yongava/-/README.md

# Honeycomb Pickleball Paddle

ไม้พิกเกิลบอลแบบชิ้นเดียว ไม่มีแผ่นผิวหน้า หน้าไม้เป็นรังผึ้งหกเหลี่ยมที่ทะลุตลอดความหนา
ยึดด้วยขอบตันรอบหน้าไม้ และต่อเป็นชิ้นเดียวกับด้ามจับทรงแปดเหลี่ยมยาว 6 นิ้ว
โดยหน้าไม้อยู่กึ่งกลางความหนาของด้าม มีสามทรง คือมาตรฐาน, hybrid และ elongated
โดยอิงขนาดจากไม้รุ่นปัจจุบันของ Selkirk, JOOLA และ RPM

โครงหน้าไม้ใช้หลัก "กรอบหนัก โครงในเบา" ผนังรังผึ้งด้านในบาง 0.8 mm
และขอบด้านข้างช่วง 3 กับ 9 นาฬิกาหนาขึ้นเป็นแผ่นตัน (side pad)
ซึ่งเป็นผลจากการเทียบรูปแบบโครงหน้าไม้ในหัวข้อ [งานวิจัยรูปแบบโครงหน้าไม้](#งานวิจัยรูปแบบโครงหน้าไม้)
(ฉบับมีแผนที่การเด้งของลูก: [Paddle Lattice Study](https://claude.ai/artifact/4r3fAmXzSW8QdgEV1mNDPP))

แบบล่าสุดคือทรง elongated แกนรังผึ้ง 14 mm หุ้มผิวตาข่ายถักด้านละ 0.8 mm เพื่อเพิ่มสปิน
(ดู [ผิวตาข่ายถักบนแกน 14 mm](#ผิวตาข่ายถักบนแกน-14-mm) และโมเดล 3 มิติที่มีปุ่มเปิดปิดผิว:
[Honeycomb Pickleball Paddle](https://claude.ai/artifact/HdFxA8h9m2yCLM3t2ezmrv))

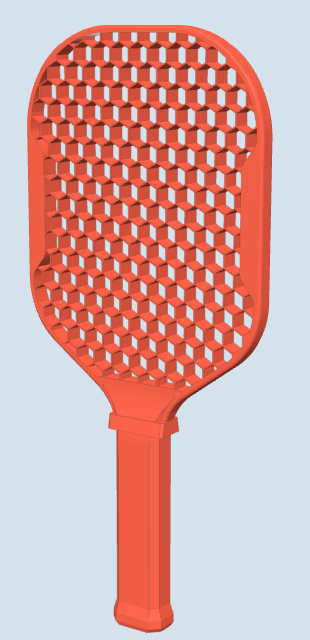
[picture p1: preview.png]
Elongated paddle preview


## ไฟล์

| ไฟล์ | รายละเอียด |
| --- | --- |
| `stl/pickleball_paddle_standard.stl` | ทรงมาตรฐาน |
| `stl/pickleball_paddle_hybrid.stl` | ทรง hybrid |
| `stl/pickleball_paddle_elongated.stl` | ทรง elongated |
| `stl/pickleball_paddle_<ทรง>_flat16.stl` | แบบพิมพ์นอน: หน้าไม้หนา 16 mm เท่าด้าม ช่องรังผึ้ง 18 mm (ดู [16 mm พิมพ์นอน](#16-mm-พิมพ์นอน)) |
| `stl/pickleball_paddle_elongated_diamond.stl` | ทางเลือก: ทรง elongated โครงลายข้าวหลามตัด ผนัง 1.0 mm |
| `stl/pickleball_paddle_elongated_mesh.stl` | แบบล่าสุด: ทรง elongated แกน 14 mm หุ้มผิวตาข่ายถักด้านละ 0.8 mm พิมพ์นอนชิ้นเดียว |
| `stl/pickleball_paddle_elongated_mesh_core.stl` | แกนเดียวกันแบบไม่มีผิว ผนังต่ำกว่าขอบด้านละ 0.8 mm |
| `generate_paddle.py` | สคริปต์สร้างโมเดล ปรับค่าได้จาก `HANDLE_LENGTH`, `SHAPES`, `LAY_FLAT`, `MESH_DESIGN` และค่าคงที่ที่ส่วนบนของไฟล์ |
| `analyze_paddle.py` | สคริปต์คำนวณน้ำหนัก swing weight, twist weight และแผนที่ sweet spot (รวมผิวตาข่ายถ้ามี) |
| `optimize_flat.py` | วนหาแบบพิมพ์นอนที่ดีที่สุดที่ความหนาที่กำหนด ทั้งแบบโครงเปิดและแบบมีผิวตาข่าย |
| `spin_model.py` | แบบจำลองสปินของลูกที่กระทบหน้าไม้แบบเฉียง เทียบผิวหน้าแบบต่าง ๆ |

## ทรง

ทุกทรงมีมุมบนมนรัศมีใหญ่ ด้านข้างตรง และส่วนล่างเรียวเป็นรูปตัว V ลงไปหาคอไม้
แล้วโค้งเว้าเข้าด้าม มีปลอกคอหุ้มรอยต่อระหว่างด้ามกับหน้าไม้ เหมือนไม้รุ่นปัจจุบัน
มุมบนและส่วนเรียวของทรง elongated ฟิตจากภาพ JOOLA Perseus (คลาดเคลื่อน RMS 0.9 mm)
แต่ด้านข้างตรงสั้นกว่า 15 mm เพราะด้ามยาวกว่า

| | มาตรฐาน | Hybrid | Elongated |
| --- | --- | --- | --- |
| ยาว × กว้าง | 400 × 197 mm (15.75 × 7.76 in) | 412.5 × 195.5 mm (16.24 × 7.70 in) | 419 × 190 mm (16.50 × 7.48 in) |
| ยาว + กว้าง (กติกาไม่เกิน 24 in) | 23.50 in | 23.94 in | 23.98 in |
| ความยาวด้าม (ถึงคอไม้) | 152.4 mm (6.00 in) | 152.4 mm (6.00 in) | 152.4 mm (6.00 in) |
| รัศมีมุมบน | 52 mm | 62 mm | 70 mm |
| ขอบด้านข้างหนาเพิ่ม (side pad) | 7 mm | 7 mm | 11 mm |
| ช่องรังผึ้ง | 219 | 223 | 209 |
| น้ำหนักโดยประมาณ | 223 g (7.9 oz) | 220 g (7.8 oz) | 224 g (7.9 oz) |
| จุดสมดุลจากปลายด้าม | 218 mm | 223 mm | 228 mm |
| Swing weight | 89 kg·cm² | 94 kg·cm² | 100 kg·cm² |
| Twist weight | 6.74 kg·cm² | 6.50 kg·cm² | 6.53 kg·cm² |
| ฐานพิมพ์จัตุรัสขั้นต่ำ (ตั้งสันข้าง วางทแยง) | 296 mm | 305 mm | 309 mm |
| ความสูงตอนพิมพ์ | 197 mm | 196 mm | 190 mm |

ทุกทรงใช้ค่าเดียวกันดังนี้: หน้าไม้หนา 13 mm, ขอบตัน 4.5 mm, ช่องรังผึ้งห่างกัน 15 mm ผนัง 0.8 mm,
ด้ามแปดเหลี่ยม 36 × 24 mm (เส้นรอบวง 108 mm หรือ 4.25 in) หน้าไม้อยู่กึ่งกลางด้าม
ด้ามจึงนูนออกจากหน้าไม้ด้านละ 5.5 mm

ความยาวรวมคงไว้ให้อยู่ในกติกา ด้ามที่ยาว 6 นิ้วจึงทำให้หน้าไม้สั้นกว่าไม้จริง 15–19 mm

น้ำหนักและค่าอื่นทั้งหมดคำนวณจากโมเดล โดยใช้ PETG ความหนาแน่น 1.25 g/cm³
ถือว่าหน้าไม้ตัน 100% และด้ามเติมเนื้อ 35%

## งานวิจัยรูปแบบโครงหน้าไม้

### วัดอะไรบ้าง

- **Swing weight:** โมเมนต์ความเฉื่อยรอบแกนที่ห่างจากปลายด้าม 5 cm หน่วย kg·cm² แบบเดียวกับเครื่อง Briffidi SW1 ที่ Pickleball Effect ใช้ ไม้ทั่วไปอยู่ที่ 70–130 เฉลี่ยราว 105
- **Twist weight:** โมเมนต์ความเฉื่อยรอบแกนกลางตามความยาวไม้ หน่วย kg·cm² ยิ่งสูงไม้ยิ่งบิดน้อยเมื่อตีไม่โดนกลาง
- **จุด center of percussion:** คิดจากจุดหมุนที่กลางฝ่ามือ 3 นิ้วจากปลายด้าม ตามวิธีของ Pickleball Science
- **Sweet spot:** จำลองลูกตกกระทบหน้าไม้ทุกจุดห่างกัน 5 mm แล้ววัดว่าลูกเด้งกลับเร็วแค่ไหน โดยแบบจำลองรวมทั้งการหมุนของทั้งไม้และการสั่นของโครงหน้าไม้ (แบบจำลองคานของผนังทุกเส้น ขอบ และด้าม) sweet spot คือพื้นที่ที่ลูกเด้งกลับอย่างน้อย 37% ของความเร็วขาเข้า (90% ของที่ไม้แข็งไม่บิดงอน้ำหนัก 213 g ทำได้ดีที่สุด) เวลาที่ลูกสัมผัสหน้าไม้ยังไม่มีใครวัดได้แน่ชัด จึงคำนวณทั้ง 1, 2 และ 4 ms

ค่าอ้างอิง: JOOLA Perseus Pro V 16mm หนัก 7.95 oz, swing weight 117, twist weight 6.26 ([Pickleball Effect](https://pickleballeffect.com/paddles/joola-perseus-pro-v-16mm/))

### เทียบรูปแบบที่น้ำหนักเท่ากัน

ทรง elongated ผนัง 1.0 mm ไม่มี side pad ทุกแบบใช้ความยาวผนังต่อพื้นที่เท่ากัน จึงหนักเท่ากัน

| รูปแบบ | น้ำหนัก | Swing weight | Twist weight | ความถี่โค้งงอ | ความถี่บิด | Sweet spot 1/2/4 ms | ช่วงผนังไร้ค้ำ |
| --- | --- | --- | --- | --- | --- | --- | --- |
| รังผึ้ง | 212.6 g | 93.5 | 4.95 | 52 Hz | 80 Hz | 2 / 14 / 34 cm² | 8.7 mm |
| สี่เหลี่ยม | 212.4 g | 93.3 | 5.00 | 75 Hz | 83 Hz | 7 / 10 / 20 cm² | 15 mm |
| ข้าวหลามตัด | 211.4 g | 92.6 | 4.85 | 52 Hz | 167 Hz | 0 / 8 / 23 cm² | 15 mm |
| สามเหลี่ยม | 213.9 g | 93.9 | 5.03 | 66 Hz | 132 Hz | 3 / 10 / 22 cm² | 26 mm |
| แปดเหลี่ยม (+ สี่เหลี่ยมเล็กในช่องว่าง) | 212.8 g | 93.1 | 4.99 | 55 Hz | 84 Hz | 1 / 8 / 27 cm² | 7.7 mm |

- ที่น้ำหนักเท่ากัน รูปแบบช่องแทบไม่เปลี่ยน swing weight และ twist weight (ต่างกันไม่เกิน 2%) เพราะสองค่านี้ขึ้นกับว่าเนื้อวัสดุอยู่ตรงไหน ไม่ใช่รูปร่างช่อง
- รูปแบบช่องเปลี่ยนความแข็งได้ สี่เหลี่ยมและสามเหลี่ยมแข็งต่อการโค้งงอกว่า ข้าวหลามตัดแข็งต่อการบิดกว่ารังผึ้งราว 2 เท่าในแง่ความถี่ แต่อันดับ sweet spot สลับไปมาตามเวลาสัมผัสลูก จึงสรุปไม่ได้ว่ารูปแบบไหนดีกว่าเพียงเพราะรูปร่างช่อง
- รังผึ้งมีช่วงผนังไร้ค้ำสั้นที่สุด เมื่อลูกกระแทกขอบผนัง ผนังยาวโก่งได้ง่ายกว่ามาก ประมาณการคร่าว ๆ คือที่น้ำหนักเท่ากัน รังผึ้งรับแรงก่อนผนังโก่งได้ราว 5 เท่าของข้าวหลามตัด จึงทำผนังให้บางได้มากที่สุด
- ทุกแบบยังอ่อนกว่าไม้คาร์บอนจริงมาก ไม้จริงที่ Pickleball Science วัดมีโหมดสั่นราว 1 kHz ส่วนโครงพิมพ์ไร้แผ่นผิวมีโหมดแรกแค่ 50–170 Hz

### สิ่งที่ได้ผลจริง: กรอบหนัก โครงในเบา

ย้ายเนื้อวัสดุจากโครงด้านในไปไว้ที่ขอบด้านข้าง (เหมือนติดเทปตะกั่วที่ 3 กับ 9 นาฬิกา
และเหมือนไม้เทนนิสที่กรอบหนักแต่เอ็นเบา) ทำให้ทั้ง twist weight และ sweet spot ดีขึ้นในทุกสมมติฐาน
ทั้งเวลาสัมผัส 1–4 ms, การหน่วงของวัสดุ 2–5%, ค่า E ของ PETG ที่พิมพ์ 1.6–2.0 GPa และค่าการเด้งของลูก 0.5–0.6

| ทรง elongated | น้ำหนัก | Swing weight | Twist weight | Sweet spot 1/2/4 ms | ลูกเด้งเฉลี่ยในวงรี 4.5 × 2.5 นิ้ว |
| --- | --- | --- | --- | --- | --- |
| เดิม: รังผึ้ง ผนัง 1.0 mm | 212.6 g | 93.5 | 4.95 | 2 / 14 / 34 cm² | 0.31 |
| ใหม่: รังผึ้ง ผนัง 0.8 mm + side pad 11 mm | 223.9 g | 99.7 | 6.53 | 34 / 39 / 58 cm² | 0.40 |
| ข้าวหลามตัด ผนัง 0.8 mm + side pad 11 mm | 223.2 g | 99.2 | 6.48 | 34 / 40 / 50 cm² | 0.40 |
| แปดเหลี่ยม ผนัง 0.8 mm + side pad 11 mm | 223.0 g | 99.0 | 6.51 | 20 / 33 / 50 cm² | 0.37 |
| ทางเลือก: ข้าวหลามตัด ผนัง 1.0 mm + side pad 6 mm | 226.3 g | 101.8 | 6.00 | 8 / 23 / 45 cm² | 0.35 |

ที่น้ำหนักเท่ากับแบบเดิมพอดี (ประมาณ 210 g ผนัง 0.72 mm + pad 8 mm) sweet spot ก็ยังโตจาก 2/14/34 เป็น 34/40/52 cm²
แปลว่าที่ดีขึ้นมาจากการย้ายตำแหน่งน้ำหนัก ไม่ใช่จากการเพิ่มน้ำหนัก

**สรุป:** เก็บช่องรังผึ้งไว้ แต่เปลี่ยนการกระจายน้ำหนักเป็นกรอบหนัก โครงในเบา ถ้าอยากได้ลายอื่น
ข้าวหลามตัดได้ sweet spot ใกล้เคียงกัน แข็งต่อการบิดกว่า และตอนพิมพ์ตั้งสันข้างไม่มีสะพานเลย
แต่ต้องใช้ผนังหนาขึ้นเป็น 1.0 mm เพื่อไม่ให้ผนังที่ยาวกว่าโก่งตอนตีแรง ไม้จึงหนักขึ้นและ sweet spot เล็กลง

แปดเหลี่ยมปูเต็มระนาบเองไม่ได้ ต้องมีสี่เหลี่ยมเล็กแทรกในช่องว่าง ได้ช่องใหญ่ราว 18 mm ปนช่องเล็ก
แข็งกว่ารังผึ้งเล็กน้อย (5–8% ในแง่ความถี่) แต่ sweet spot เล็กกว่าในทุกกรณี จึงไม่ดีกว่ารังผึ้ง

### จุดอ่อนของงานพิมพ์ 3D

งานพิมพ์ FDM แข็งแรงตามแนวเส้นพลาสติก แต่รอยต่อระหว่างชั้นมักรับแรงดึงได้เพียงราวครึ่งเดียวและแตกแบบเปราะ
เมื่อพิมพ์แบบตั้งสันข้าง ชั้นจะเรียงตามความกว้างของไม้ ผนังที่วิ่งตามความยาวไม้จึงแข็งแรง
แต่ผนังเฉียงของรังผึ้ง (2 ใน 3 ของผนังทั้งหมด) และขอบบนของหน้าไม้เป็นชั้นซ้อนกัน จึงเป็นจุดที่จะร้าวก่อน

ลองแนวทางใหม่สองแบบในแบบจำลองเดียวกัน (ทรง elongated)

| แบบ | น้ำหนัก | Swing weight | Twist weight | ความถี่โค้งงอ / บิด | Sweet spot 1/2/4 ms |
| --- | --- | --- | --- | --- | --- |
| ตอนนี้: หน้าไม้ 13 mm พิมพ์ตั้งสันข้าง | 223.9 g | 99.7 | 6.53 | 55 / 100 Hz | 34 / 39 / 58 cm² |
| แกนคาร์บอน: แท่งคาร์บอน 2 mm สองเส้นจากปลายด้ามถึงปลายหน้าไม้ | 233.6 g | 106.1 | 6.53 | 136 / 103 Hz | 18 / 12 / 23 cm² |
| หน้าไม้หนา 18 mm พิมพ์นอน (ด้าม 42 × 18 mm) | 222.9 g | 101.8 | 6.53 | 66 / 105 Hz | 25 / 42 / 42 cm² |
| หน้าไม้หนา 20 mm พิมพ์นอน (ด้าม 40 × 20 mm) | 225.5 g | 100.0 | 6.20 | 71 / 111 Hz | 20 / 47 / 28 cm² |

- แกนคาร์บอนทำให้ไม้แข็งขึ้น 2.5 เท่าและกันไม้หักได้ แต่ sweet spot เล็กลงมาก เพราะแกนแข็งกลางหน้าไม้ทำลายแรงดีดของโครงด้านในที่ทำงานเหมือนเอ็นไม้เทนนิส
- หน้าไม้หนาเท่าด้ามทำให้พิมพ์นอนได้โดยไม่ต้องใช้ซัพพอร์ตเลย และผนังทุกเส้นวิ่งตามแนวเส้นพลาสติก จึงแข็งแรงกว่ามาก
  แข็งขึ้น 20–30% และ sweet spot ใกล้เคียงเดิม แต่ด้ามแบนกว่าเดิม (เส้นรอบวงเท่าเดิม 108 mm) ช่องใหญ่ขึ้นเป็น 18–22 mm และต้องใช้ฐานพิมพ์ราว 350 mm

### 16 mm พิมพ์นอน

ภาพความเร็วสูงของ John Kew แสดงว่าลูกแนบหน้าไม้ไม่เกิน 2 ms
จึงให้น้ำหนักกับผลที่ 1–2 ms เป็นหลัก ทุกแบบถูกปรับขอบด้านข้างให้หนัก 225 g เท่ากัน

ถ้าแค่เปลี่ยนเป็น 16 mm โดยใช้โครงเดิม (ช่อง 15 mm ผนัง 0.8 mm) ไม้จะแข็งขึ้น 24% แต่ sweet spot เล็กลง
(19 / 36 / 53 cm² เทียบกับ 34 / 40 / 60 cm² ของแบบ 13 mm) เพราะโครงที่ลึกขึ้นแข็งขึ้นและเสียแรงดีดไป
จึงวนหาแบบที่ดีที่สุดที่ 16 mm (`optimize_flat.py`) โดยลอง 5 ลาย ช่อง 13–19 mm ผนัง 0.8–1.0 mm ขอบ 3–6.5 mm

- ลายข้าวหลามตัด สี่เหลี่ยม และสามเหลี่ยมตกเกณฑ์เกือบทั้งหมด เพราะผนังยาวจะโก่งเมื่อตีลูกแรง (เกณฑ์คือรับแรงได้อย่างน้อย 3 เท่าของลูกตบ 800 N)
- แปดเหลี่ยมผ่านเกณฑ์แต่ sweet spot เล็กกว่ารังผึ้ง
- ช่องใหญ่ขึ้น (โครงเบาลง) แล้วย้ายน้ำหนักไปที่ขอบ ยิ่งดี จนถึงช่อง 18 mm ช่อง 19 mm ผนังจะเริ่มโก่ง
- ลองเลียนแบบไม้ foam core ด้วยวงผนังบางรอบขอบ (เหมือน floating core / EVA รอบขอบ) ไม่ช่วยเลย (34/52/61 เทียบ 34/52/60 cm² ต่างกันไม่เกินความละเอียดของกริด) และทำให้ผนังรับแรงได้แค่ 1.8 เท่า
  ส่วนวงผนังหนาก็แย่ลง เพราะดึงน้ำหนักออกจากขอบด้านข้าง

ผลที่ดีที่สุด: รังผึ้ง ช่อง 18 mm ผนัง 0.8 mm ด้าม 42.7 × 16 mm (เส้นรอบวง 108 mm)

| ทรง (225 g) | ขอบ / side pad | Swing weight | Twist weight | ความถี่โค้งงอ / บิด | Sweet spot 1/2/4 ms | เทียบ 13 mm ตั้งสันข้าง |
| --- | --- | --- | --- | --- | --- | --- |
| มาตรฐาน | 4.5 / 5.4 mm | 97.5 | 7.50 | 77 / 99 Hz | 30 / 46 / 58 cm² | 28 / 36 / 54 cm² |
| Hybrid | 4.5 / 5.7 mm | 104.3 | 7.35 | 73 / 109 Hz | 31 / 46 / 60 cm² | 28 / 36 / 56 cm² |
| Elongated | 5.5 / 3.8 mm | 109.3 | 6.77 | 72 / 117 Hz | 34 / 52 / 60 cm² | 34 / 39 / 58 cm² |

แบบ 16 mm พิมพ์นอนดีกว่าแบบ 13 mm ในทุกทรง: sweet spot ที่ 2 ms ใหญ่ขึ้น 28–33% twist weight สูงขึ้น ไม้แข็งขึ้น
และผนังทุกเส้นพิมพ์ตามแนวเส้นพลาสติก ผลนี้ยังคงอยู่เมื่อลองการหน่วง 5%, E 1.6 GPa และลูกที่เด้งได้ 0.5 (ที่ 1–2 ms)
ข้อแลกคือ swing weight สูงขึ้นราว 10 ด้ามแบนกว่าเดิม ช่องกว้าง 17 mm ผนังรับแรงได้ 3.3 เท่า (แบบ 13 mm ได้ 5.6 เท่า)
และต้องใช้ฐานพิมพ์ราว 350–400 mm

### ผิวหน้าสำหรับสปินสูงสุด

ข้อมูลจาก John Kew: เมื่อทำให้ grit เท่ากันทุกไม้ ไม้แข็งกับไม้นุ่มต่างกันแค่ราว 250 rpm แต่เอา grit ออกเสียไปถึง 1,000 rpm
แบบจำลอง `spin_model.py` (ลูกกลวงกระทบหน้าไม้แบบเฉียง มีแรงเสียดทาน การยึดเกาะ และการดีดกลับด้านข้าง)
จำลองแท่นทดสอบของ John Kew คือลูก 70 mph ใส่ไม้ที่เอียง 30° โดยปรับให้ค่าแรงเสียดทาน 0.20 ได้ราว 2,000 rpm เท่าไม้ทั่วไป

| ผิว | แรงเสียดทาน | สปินที่ 70 mph | สปินที่ 40 mph | ลูกไถล |
| --- | --- | --- | --- | --- |
| ขอบผนัง PETG ที่พิมพ์ออกมา (ประมาณ) | 0.22 | 2,200 rpm | 1,260 rpm | 28 mm |
| Grit บนสันผนัง | 0.40 | 4,000 rpm | 2,290 rpm | 17 mm |
| ตาข่ายถักที่เชื่อมจุดไขว้ | 0.50 | 4,890 rpm | 2,790 rpm | 14 mm |
| ดอกยาง TPU บนสันผนัง | 0.90 | 7,590 rpm | 4,340 rpm | 13 mm |
| ครีบบางที่สปริงได้ | 0.45 | 3,470 rpm | 1,980 rpm | 6 mm |
| เส้นถักที่เลื่อนได้อิสระ | 0.45 | 2,080 rpm | 1,190 rpm | 8 mm |

- ในการทดสอบจริงลูกไถลตลอดการสัมผัส สปินจึงขึ้นกับแรงเสียดทานเกือบทั้งหมด
- เมื่อแรงเสียดทานเกินราว 0.35 ลูกจะยึดเกาะ แล้วความแข็งด้านข้างของผิวเริ่มสำคัญ ผิวจะดีดกลับทันในเวลาสัมผัสเมื่อแข็งด้านข้างราว 0.3–0.4 เท่าของด้านตั้งฉาก
- ผิวที่นุ่มด้านข้างมากเกินไป เช่นเส้นถักที่เลื่อนได้อิสระแบบเอ็นเทนนิส ได้สปินน้อยลง เพราะดีดกลับไม่ทันก่อนลูกออก
- ถ้าจะถักผิว ให้ถักแบบเชื่อมจุดไขว้ เน้นปุ่มนูนที่จุดไขว้ (0.3–0.5 mm) และใช้วัสดุที่ฝืด เช่น TPU
- ตัวเลขดอกยาง TPU เป็นเพดานจากแบบจำลองอย่างง่าย สปินสูงแลกกับความเร็วลูกที่ลดลง (ในแท่นทดสอบ 23.5 m/s เหลือ 12.4 m/s)
- วัดแรงเสียดทานของผิวที่พิมพ์ได้เอง: ติดลูกสามลูกเข้าด้วยกันเป็นสามเหลี่ยมเพื่อไม่ให้กลิ้ง วางบนแผ่นทดสอบแล้วค่อย ๆ เอียงจนเริ่มไถล
  ค่าแรงเสียดทานคือ tan ของมุมนั้น (เป้าหมาย 0.4 ขึ้นไป หรือราว 22°)

### ผิวตาข่ายถักบนแกน 14 mm

แกนรังผึ้งหนา 14 mm หุ้มด้วยตาข่ายที่เชื่อมทุกจุดไขว้ หนาด้านละ 0.8 mm รวม 15.6 mm (14 + 0.8 × 2)
หนาเท่าด้ามจึงยังวางนอนพิมพ์ได้โดยไม่ต้องใช้ซัพพอร์ต ผิวแบ่งเป็นส่วน นับจากแกนออกมา

| ส่วน | ระดับ | รายละเอียด |
| --- | --- | --- |
| เส้นทิศ A (+45°) | 0–0.6 mm | เส้นตรงกว้าง 0.8 mm พาดข้ามช่องจากผนังถึงผนัง บนหน้าบนพิมพ์ก่อนแบบสะพาน |
| ฝาผนัง | 0–0.4 mm | ปิดบนผนังทุกเส้น กว้างกว่าผนังข้างละ 0.1 mm ยึดผนังทุกเส้นกับผิว แม้ผนังที่เส้น A ตัดผ่านแบบเฉียงมาก |
| เส้นทิศ B (−45°) | 0.4–0.6 mm | เชื่อมกับเส้น A ทุกจุดไขว้ |
| ปุ่มนูน | 0.6–0.8 mm | กว้าง 1.0 mm ยาวเท่าระยะห่างตาข่าย อยู่ที่จุดไขว้ สลับทิศทีละจุดแบบผ้าทอ |

ผิวด้านหลังคือผิวเดียวกันที่พลิกกลับรอบแกนยาวของไม้ ทั้งสองหน้าจึงเหมือนกัน

- ผิว PETG ที่ยึดกับผนังทุกเส้นทำให้หน้าไม้กลายเป็นแผ่นแซนด์วิช ถ้าใช้โครงเดิม (ช่อง 18 mm ตาข่ายห่าง 4 mm)
  โหมดบิดขึ้นจาก 117 เป็น 160 Hz ผิวหนักราว 18 g ซึ่งต้องเอาออกจากขอบด้านข้าง และ sweet spot ที่ 2 ms ลดจาก 52 เหลือ 38 cm²
- ผิว TPU ที่นุ่มไม่เพิ่มความแข็ง แต่กลับแย่กว่าที่ 1–2 ms (29 cm²) และดีกว่าเฉพาะที่ 4 ms เพราะเมื่อลูกแนบสั้นหน้าไม้ต้องดีดกลับเร็ว
  ความแข็งของผิว PETG จึงช่วยได้ สิ่งที่เสียไปจริงคือน้ำหนักของผิว
- ผิวค้ำขอบบนของผนังไม่ให้โก่ง จึงขยายช่องได้ และตาข่ายที่ห่างขึ้นเบาลง เหลือน้ำหนักไปไว้ที่ขอบด้านข้างมากขึ้น

วนหาใหม่ 27 แบบต่อทรง (`optimize_flat.py --thickness 14 --skin 0.8`) ช่อง 18–20 mm ขอบ 3–5.5 mm ตาข่ายห่าง 4–6 mm
ทุกแบบหนัก 225 g เกณฑ์การโก่งคิดระยะค้ำตามระยะห่างตาข่าย และผนังต้องรับแรงกดจากลูกตบได้อย่างน้อย 1.5 เท่า

| ทรง (225 g) | ช่อง | ขอบ / side pad | ตาข่ายห่าง | Swing weight | Twist weight | Sweet spot 1/2/4 ms |
| --- | --- | --- | --- | --- | --- | --- |
| **Elongated (เลือก)** | 19 mm | 4.5 / 7.7 mm | 6 mm | 108.4 | 7.02 | 31 / 46 / 50 cm² |
| Hybrid | 20 mm | 4.5 / 5.4 mm | 5 mm | 105.2 | 7.22 | 26 / 45 / 49 cm² |
| มาตรฐาน | 20 mm | 4.5 / 4.9 mm | 5 mm | 99.5 | 7.35 | 24 / 42 / 45 cm² |

เลือกทรง elongated เพราะได้ sweet spot ใหญ่ที่สุดที่ 1–2 ms (เฉลี่ย 39 cm² เทียบกับ 36 และ 33 cm²) และนำมาทุกรอบของการวิเคราะห์
ข้อแลกคือ twist weight ต่ำสุดและ swing weight สูงสุดในสามทรง แต่ยังดีกว่าไม้ elongated รุ่นจริงที่ใช้อ้างอิง
(JOOLA Perseus Pro V 16mm: swing weight 117, twist weight 6.26; RPM Jade Elongated 16mm: 113 และ 5.94)

เทียบกับแบบ 16 mm ที่ไม่มีผิว ทรงเดียวกัน: sweet spot 31 / 46 / 50 เทียบกับ 34 / 52 / 60 cm² twist weight สูงขึ้น (7.02 เทียบกับ 6.77)
และผิวสองด้านหนัก 16 g สปินขึ้นกับแรงเสียดทานของผิว PETG ถักซึ่งยังไม่ได้วัด ที่ 0.3 ได้ราว 3,000 rpm และที่ 0.5 ได้ราว 4,890 rpm
(ขอบผนังเปล่า 2,200 rpm) ถ้าวัดได้ต่ำกว่า 0.4 ลองพิมพ์เฉพาะชั้นปุ่มนูนด้วย TPU แบบสองวัสดุ ปุ่มไม่รับแรงในโครงจึงไม่เปลี่ยน sweet spot
แต่แบบจำลองให้สปินราว 6,000 rpm

### ข้อจำกัดของแบบจำลอง

- เป็นแบบจำลองคาน (grillage) ของผนัง ขอบ และด้าม ไม่ใช่ FEA สามมิติเต็มรูปแบบ และยังไม่ได้ทดสอบกับชิ้นงานจริง
- ตัวเลข sweet spot ใช้เทียบระหว่างแบบ ค่าสัมบูรณ์ขึ้นกับเวลาสัมผัสลูก (ภาพของ John Kew บอกว่าไม่เกิน 2 ms)
- แบบจำลองสปินใช้จุดสัมผัสเดียวและสปริงเชิงเส้น ค่าแรงเสียดทานของผิวแต่ละแบบเป็นค่าประมาณ ควรวัดจริง
- การประเมินการโก่งของผนังเป็นการคำนวณคร่าว ๆ จากทฤษฎีคานลึก ควรทดสอบชิ้นงานจริงก่อนตีแรง ๆ
- ผิวตาข่ายคิดเหมือนแผ่นที่ยึดกับผนังแน่นตลอด ถ้ารอยต่อระหว่างผิวกับผนังยืดหรือเลื่อน ผิวจะช่วยให้แข็งน้อยกว่าที่คำนวณ

แหล่งข้อมูล: [Pickleball Science: swing weight](https://pickleballscience.org/what-do-the-swing-weight-numbers-mean/),
[Pickleball Science: sweet spot](https://pickleballscience.org/where-is-the-sweet-spot/),
[Pickleball Science: sweet spot size](https://pickleballscience.org/how-large-is-the-sweet-spot/),
[Pickleball Effect: วิธีทดสอบ](https://pickleballeffect.com/?p=39472),
[Pickleball Central: swingweight และ twistweight](https://pickleballcentral.com/blog/the-lab-at-pickleball-central-why-swingweight-twistweight-and-balance-points-matter-in-pickleball/),
[Pickleball Central: การติดเทปถ่วงน้ำหนัก](https://pickleballcentral.com/blog/lab-breakdown-ultimate-guide-to-using-weighted-tape/),
[The Dink: ภาพความเร็วสูงเรื่อง dwell time](https://www.thedinkpickleball.com/is-dwell-time-a-pickleball-myth-what-high-speed-footage-actually-reveals/),
[John Kew: Boomstik Infinigrit update](https://johnkewpickleball.beehiiv.com/p/johnkew-newsletter-boomstik-infinigrit-update),
[Pickleball.com: John Kew spin testing](https://pickleball.com/gear/john-kew-taking-spin-testing-to-the-next-level),
[Pickleball Science: friction and spin](https://pickleballscience.org/does-friction-create-more-spin/),
[Pickleball Effect: RPM Jade Elongated 16mm](https://pickleballeffect.com/paddles/rpm-jade-elongated-16mm/),
[Pickleball Effect: foam vs polymer cores](https://pickleballeffect.com/resources/foam-vs-polymer-core-breakdown/)

## ไม้รุ่นจริงที่ใช้อ้างอิง

| รุ่น | ทรง | ยาว (in) | กว้าง (in) | ด้าม (in) |
| --- | --- | --- | --- | --- |
| JOOLA Perseus | Elongated, หัวเหลี่ยม | 16.5 | 7.5 | 5.5 |
| JOOLA Hyperion | Elongated, หัวมน | 16.5 | 7.5 | 5.5 |
| RPM Friction Pro Elongated | Elongated | 16.5 | 7.5 | 5.5 |
| Selkirk Elongated | Elongated | 16.5 | 7.45 | 5.8 |
| Selkirk Invikta | Elongated | 16.5 | 7.375 | 5.25 |
| RPM Q2 Hybrid Flat Top | Hybrid | 16.25 | 7.7 | 5.5 |
| Selkirk Epic | มาตรฐาน | 15.75 | 8 | 5.25 |

ที่มา: [Selkirk shapes](https://www.selkirk.com/pages/shapes),
[Pickleheads: Perseus vs Hyperion](https://www.pickleheads.com/pickleball-gear/joola-perseus-vs-hyperion),
[Pickleball Central: RPM Friction Pro Elongated](https://pickleballcentral.com/rpm-friction-pro-14mm-elongated-v2-pickleball-paddle/),
[Matt's Pickleball: RPM Q2 Hybrid Flat Top](https://www.mattspickleball.com/paddle/q2-hybrid-flat-top-16mm)

## การพิมพ์

ด้ามนูนออกจากหน้าไม้ทั้งสองด้าน ถ้าวางนอน หน้าไม้จะลอยจากฐาน 5.5 mm ทั้งแผ่น จึงควรพิมพ์แบบตั้งสันข้าง

- ตั้งไม้บนสันข้างยาว ให้หน้าไม้ตั้งฉากกับฐาน (ในสไลเซอร์ หมุน 90° รอบแกนความยาวของไม้) side pad ทำให้สันที่แตะฐานกว้างขึ้นด้วย
- ช่องรังผึ้งจะกลายเป็นอุโมงค์แนวนอน เพดานแต่ละช่องเป็นสะพานยาวประมาณ 8 mm พิมพ์ได้โดยไม่ต้องมีซัพพอร์ตข้างใน
- ใช้ซัพพอร์ตแบบ tree ตั้งค่าให้แตะฐานเท่านั้น จะเกิดซัพพอร์ตใต้ด้ามและปลอกคอ (สูงจากฐาน 6–8 cm) และใต้โค้งปลายสองข้างของขอบล่าง (สูงไม่เกิน 2 cm)
- ใส่ brim 5–8 mm กันล้ม
- ฐานจัตุรัสตั้งแต่ 310 mm ขึ้นไปพอเมื่อวางทแยง และต้องพิมพ์ได้สูงประมาณ 200 mm ฐาน 350×350 ใส่ได้ทุกทรงพร้อม brim
- แนะนำ PETG เพราะทนแรงกระแทกดีกว่า PLA ผนัง 0.8 mm คือเส้นผนัง 2 เส้นจากหัวฉีด 0.4 mm ตั้งความกว้างเส้นราว 0.42 mm, เลเยอร์ 0.2 mm, ด้ามใช้ infill แบบ gyroid ประมาณ 15–20%

**แบบ 16 mm พิมพ์นอน (`_flat16`)** ทุกส่วนหนาไม่เกิน 16 mm ด้านล่างจึงเป็นระนาบเดียว

- วางนอนบนฐานได้เลย ไม่ต้องใช้ซัพพอร์ต ผนังทุกเส้นพิมพ์ตามแนวเส้นพลาสติก
- ต้องใช้ฐานจัตุรัสราว 350 mm เมื่อวางทแยง (ทรง hybrid 351 mm) แนะนำฐาน 400 mm ขึ้นไปเพื่อเผื่อ brim
- หัวฉีด 0.6 mm ทำผนัง 0.8 mm เป็นเส้นเดียวได้ ไม่มีรอยเชื่อมกลางผนัง

**แบบผิวตาข่าย (`_mesh`)** หนา 15.6 mm ทั้งหน้าไม้และด้าม

- วางนอนบนฐานได้เลย ไม่ต้องใช้ซัพพอร์ต ฐานจัตุรัสราว 350 mm เมื่อวางทแยง
- ใช้เลเยอร์ 0.2 mm ผิวแต่ละด้านจึงเป็น 4 เลเยอร์ ถ้าใช้ความสูงเลเยอร์แบบปรับได้ ให้ช่วงผิวสองด้านเป็น 0.2 mm พอดี
- ชั้นแรกบนฐานคือปุ่มนูนของผิวด้านล่าง เป็นชิ้นเล็กราว 1,100 ชิ้น ใช้ฐาน PEI ที่สะอาดหรือทากาว และพิมพ์ชั้นแรกช้า ๆ
- ชั้นแรกของผิวด้านบนพาดข้ามช่องยาวได้ถึงราว 21 mm เปิดการตรวจจับสะพาน (bridge) และพัดลมเต็มที่
- ไฟล์มีราว 160,000 สามเหลี่ยม (8 MB) เพราะปุ่มนูนทุกปุ่มเป็นรูปทรงจริง

ถ้าอยากวางนอนพิมพ์โดยไม่ใช้ซัพพอร์ตแต่ยังใช้หน้าไม้ 13 mm ใช้ `--grip flat` ได้ ด้ามจะเรียบเสมอกับด้านล่างของหน้าไม้
แต่หน้าไม้จะเยื้องจากแกนด้าม 5.5 mm

## สร้างใหม่และวิเคราะห์

```sh
pip install manifold3d numpy shapely scipy
python3 generate_paddle.py --all                       # ทุกทรง แบบแนะนำ
python3 generate_paddle.py --shape hybrid --grip flat
python3 generate_paddle.py --shape elongated --pattern diamond --wall 1.0 --side-pad 6
python3 analyze_paddle.py --shape elongated            # เทียบทุกรูปแบบ
python3 analyze_paddle.py --pattern honeycomb --wall 1.0 --side-pad 0
python3 generate_paddle.py --all --lay-flat            # แบบ 16 mm พิมพ์นอน
python3 optimize_flat.py --thickness 16 --shape elongated
python3 spin_model.py
python3 generate_paddle.py --mesh                      # แบบผิวตาข่าย ทรง elongated
python3 generate_paddle.py --mesh --no-skin            # แกนเดียวกันแบบไม่มีผิว
python3 optimize_flat.py --thickness 14 --skin 0.8 --shape elongated
```

รูปแบบที่มีให้เลือก: `honeycomb`, `square`, `diamond`, `triangle`, `octagon`

## ข้อควรรู้

- กติกา USA Pickleball ไม่อนุญาตให้หน้าไม้มีรู ไม้นี้จึงใช้แข่งในรายการที่รับรองไม่ได้ เหมาะกับการเล่นสนุกหรือซ้อม
- ทรง hybrid และ elongated ยาวรวมกว้างเกือบชนเพดาน 24 in เหมือนไม้จริง ถ้าพิมพ์แล้วชิ้นงานขยายตัวอาจเกินเล็กน้อย
- ผนัง 0.8 mm บางกว่าเดิม ควรลองตีเบา ๆ ก่อน และตรวจรอยร้าวที่ผนังหลังเล่น
- ผิวตาข่ายที่มีปุ่มนูนก็ผิดกติกาเรื่องผิวหน้าไม้เช่นกัน แบบนี้เป็นงานวิจัย
- `--mesh` ทรงมาตรฐานและ hybrid ได้ไฟล์ที่มีขอบเสียไม่กี่จุด สไลเซอร์ซ่อมให้อัตโนมัติ ส่วนทรง elongated สะอาดทั้งหมด
