yongava/-/stl/pickleball_paddle_elongated_mesh_core.stl

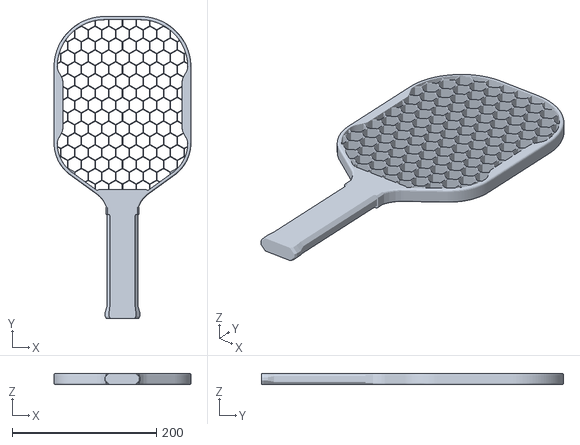
[picture p2: CAD file, 2026-11-11]
stl/pickleball_paddle_elongated_mesh_core.stl
190.0 x 419.0 x 15.6
