yongava/-/stl/pickleball_paddle_elongated_mesh.stl

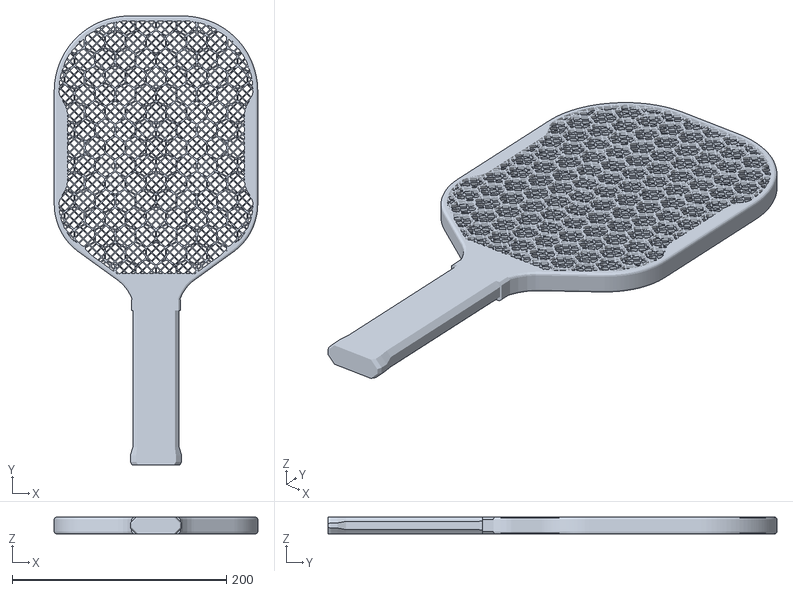
[picture p3: CAD file, 2026-11-11]
stl/pickleball_paddle_elongated_mesh.stl
190.0 x 419.0 x 15.6
