yongava/-/stl/pickleball_paddle_hybrid_flat16.stl

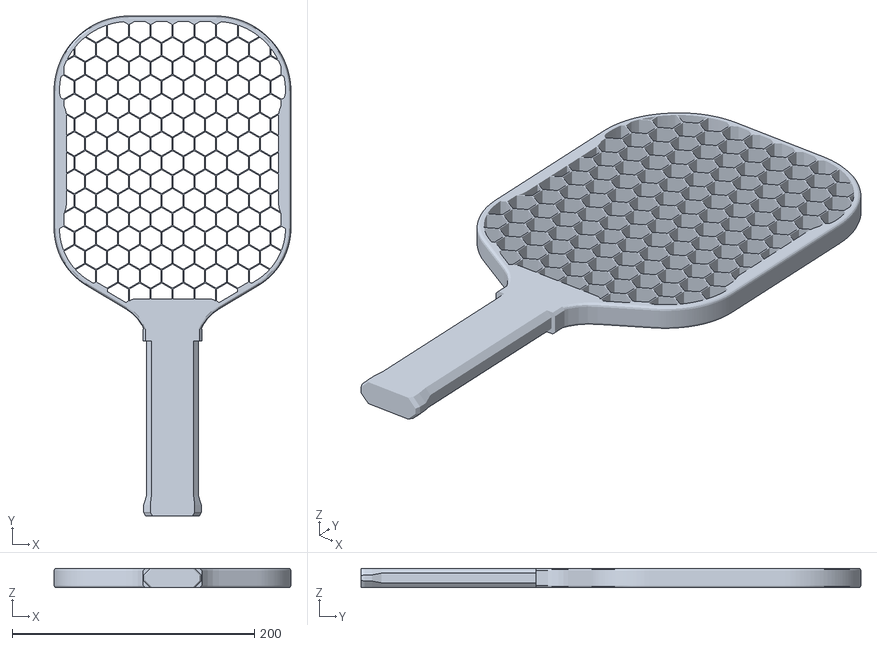
[picture p4: CAD file, 2026-11-06]
stl/pickleball_paddle_hybrid_flat16.stl
195.5 x 412.5 x 16.0
