yongava/-/stl/pickleball_paddle_standard_flat16.stl

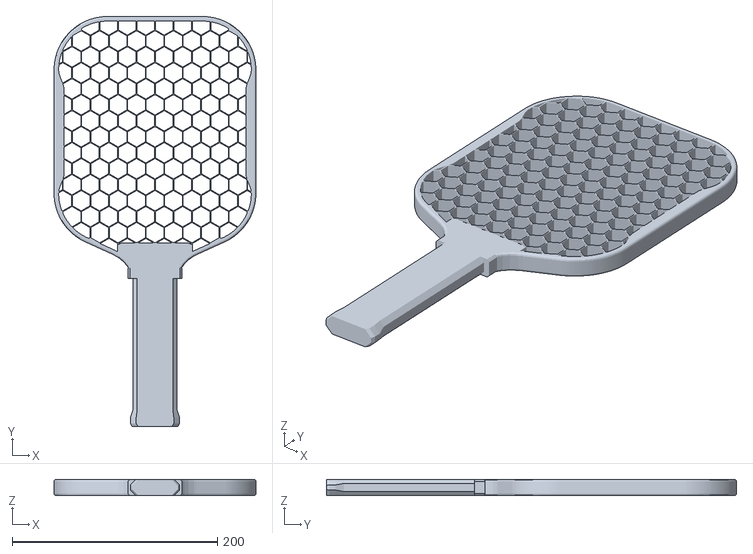
[picture p5: CAD file, 2026-11-06]
stl/pickleball_paddle_standard_flat16.stl
197.0 x 400.0 x 16.0
