yongava/-/stl/pickleball_paddle_elongated_flat16.stl

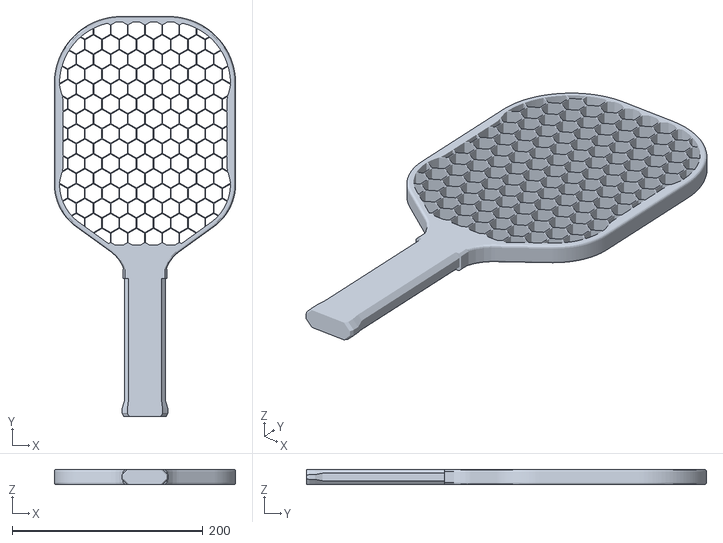
[picture p6: CAD file, 2026-11-06]
stl/pickleball_paddle_elongated_flat16.stl
190.0 x 419.0 x 16.0
