yongava/-/stl/pickleball_paddle_hybrid.stl

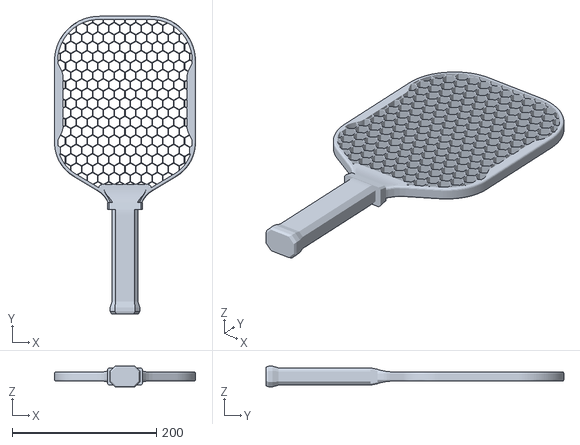
[picture p7: CAD file, 2026-11-06]
stl/pickleball_paddle_hybrid.stl
195.5 x 412.5 x 28.5
