yongava/-/stl/pickleball_paddle_elongated.stl

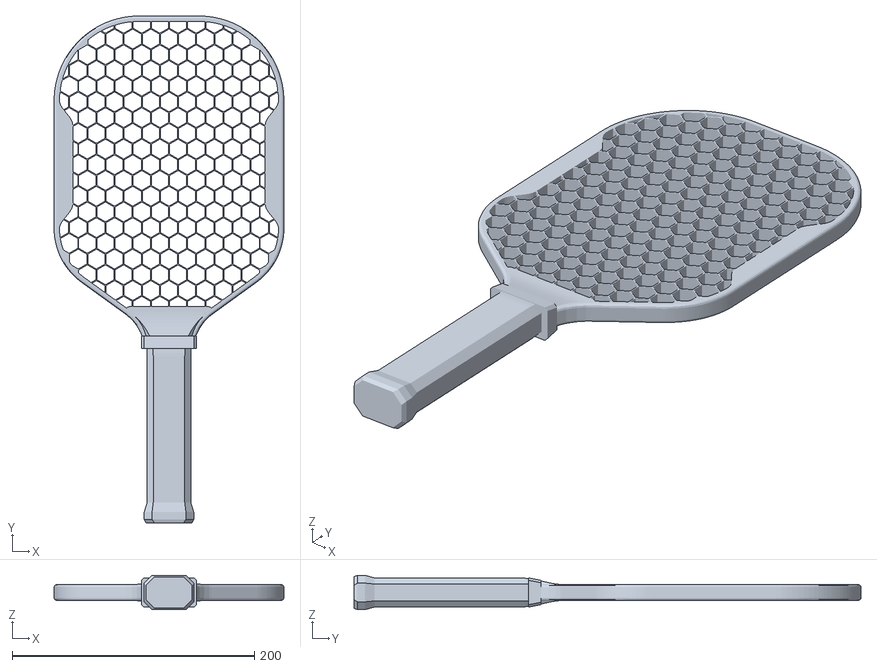
[picture p8: CAD file, 2026-11-06]
stl/pickleball_paddle_elongated.stl
190.0 x 419.0 x 28.5
