yongava/-/stl/pickleball_paddle_standard.stl

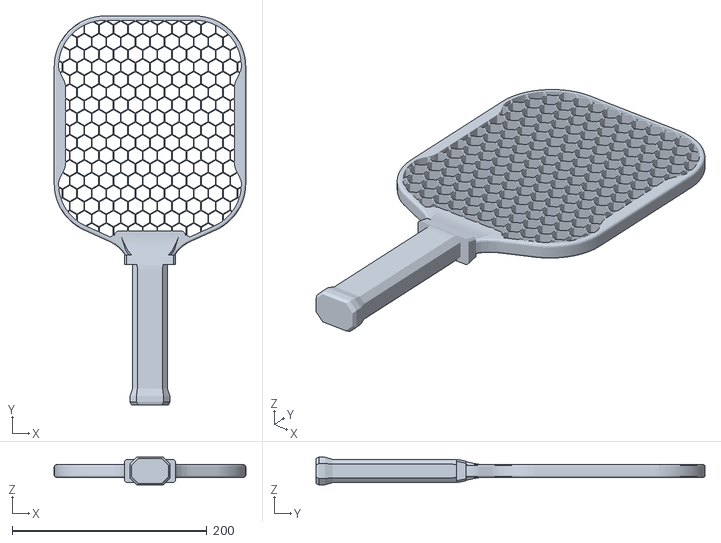
[picture p9: CAD file, 2026-11-06]
stl/pickleball_paddle_standard.stl
197.0 x 400.0 x 28.5
