yongava/-/stl/pickleball_paddle_elongated_diamond.stl

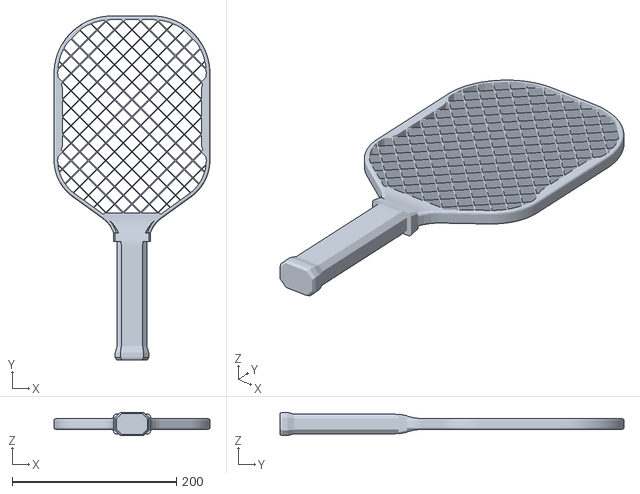
[picture p10: CAD file, 2026-11-06]
stl/pickleball_paddle_elongated_diamond.stl
190.0 x 419.0 x 28.5
