yongava/-/(commit log)

2026-10-28 Add one-piece honeycomb pickleball paddle model
    Parametric generator (manifold3d) for a skinless paddle whose face is a
    through-thickness hexagonal lattice inside a solid rim, joined to an
    octagonal grip. Includes a flat-bottom STL that prints without supports
    and a symmetric-grip variant.
    Claude-Session: https://claude.ai/code/session_01ShGC3ZCvF71dpb89cet5nC
    [pickleball_paddle.stl, pickleball_paddle_symmetric.stl]
2026-10-28 Add hybrid and elongated paddle shapes
    Shapes are sized after current production paddles (JOOLA Perseus and
    Hyperion, RPM Friction Pro and Q2 Hybrid, Selkirk Elongated, Invikta and
    Epic). generate_paddle.py takes --shape and --all, writes STLs into stl/,
    and reports balance point alongside mass and bed size.
    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
    [pickleball_paddle_elongated.stl, pickleball_paddle_elongated_symmetric.stl, pickleball_paddle_hybrid.stl, pickleball_paddle_hybrid_symmetric.stl, pickleball_paddle_standard.stl, pickleball_paddle_standard_symmetric.stl]
2026-10-29 Round paddle outlines to match production shapes
    Fit the elongated outline to a photo of a JOOLA Perseus (0.9 mm RMS):
    large top-corner radius, straight sides, and a V taper into the handle
    with concave fillets. Hybrid and standard follow the same construction.
    A lofted throat follows the curved neck and a collar wraps the
    grip-to-face step. Edges are rounded with a Minkowski sum, so the face
    outline no longer has to be convex.
    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
    [pickleball_paddle_elongated.stl, pickleball_paddle_elongated_symmetric.stl, pickleball_paddle_hybrid.stl, pickleball_paddle_hybrid_symmetric.stl, pickleball_paddle_standard.stl, pickleball_paddle_standard_symmetric.stl]
2026-11-06 Lengthen handle to 6 in and centre the grip on the face
    The handle now runs 152.4 mm from the butt to the neck on every shape.
    Overall length stays within the 24 in rule, so the face's straight sides
    get shorter; the taper is placed from the neck and keeps its shape.
    The grip is centred on the face by default (--grip centered); the old
    flush-bottom grip remains as --grip flat. Centred paddles print on their
    long edge, so the report gives that footprint and height.
    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
    [pickleball_paddle_elongated.stl, pickleball_paddle_elongated_symmetric.stl, pickleball_paddle_hybrid.stl, pickleball_paddle_hybrid_symmetric.stl, pickleball_paddle_standard.stl, pickleball_paddle_standard_symmetric.stl]
2026-11-06 Study lattice patterns and switch to a perimeter-weighted honeycomb
    Lattices are now generated as rib networks, so the face can use
    honeycomb, square, diamond or triangle cells with graded walls.
    analyze_paddle.py computes weight, swing weight (5 cm pivot), twist
    weight, centre of percussion, free-free modes of a grillage model and a
    ball rebound map scored at 1, 2 and 4 ms contact times.
    At equal weight the cell shape barely changes swing or twist weight, and
    its effect on the sweet spot flips with contact time. Moving mass from
    the lattice to the rim at 3 and 9 o'clock helps under every assumption,
    so the default is now honeycomb with 0.8 mm walls and per-shape side
    pads; a diamond varian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
    [pickleball_paddle_elongated.stl, pickleball_paddle_elongated_diamond.stl, pickleball_paddle_hybrid.stl, pickleball_paddle_standard.stl]
2026-11-06 Add octagon pattern and record layer-strength concepts
    The octagon option is the truncated square tiling (octagons with small
    squares in the gaps). At equal weight it is slightly stiffer than the
    honeycomb but has a smaller sweet spot. The README now also records two
    concepts aimed at weak FDM layer bonds: a carbon-rod spine and a face as
    thick as the grip so the paddle prints flat.
    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
2026-11-06 Add 16 mm lay-flat design, optimizer and spin model
    A face as thick as the grip lets the centred paddle print flat with every
    wall along its layers. optimize_flat.py tunes each candidate to 225 g,
    screens wall buckling and cell size, and scores the sweet spot at 1-2 ms
    (John Kew's footage puts contact under 2 ms). The best 16 mm design is
    honeycomb with 18 mm cells and 0.8 mm walls; it beats the 13 mm on-edge
    design for every shape. --lay-flat writes it as *_flat16.stl.
    spin_model.py simulates an oblique impact with friction, grip and
    sideways snapback, calibrated to ~2,000 rpm for typical paddles, and
    compares surface concepts.
    Claud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
    [pickleball_paddle_elongated_flat16.stl, pickleball_paddle_hybrid_flat16.stl, pickleball_paddle_standard_flat16.stl]
2026-11-06 Align 16 mm README numbers with the analysis output
    Round sweet-spot areas the same way as the report (half to even), and
    quote the foam-core ring test from a re-run whose side pads are tuned to
    225 g like the shipped design.
    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
2026-11-06 Fix the friction tilt test so the ball cannot roll
    A single ball on a tilted plate rolls rather than slides, so the test
    glues three balls into a triangle before tilting.
    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
2026-11-11 Add a woven mesh skin on a 14 mm core and focus on the elongated shape
    --mesh builds a 14 mm honeycomb core with a 0.8 mm fused plain-weave skin
    on each face (15.6 mm in all, as thick as the grip, so it still prints
    flat). The skin is printed as straight A strands that bridge the cells,
    caps that bond every wall, B strands, and alternating knuckles; the back
    face is the same skin turned over. --no-skin writes the bare core.
    The grillage now carries the skins as offset membranes on the rotation
    field plus their mass, and the optimizer screens braced wall buckling
    and wall crushing. A PETG skin stiffens the face and its weight comes
    out of the side pads, so cells grow to 19-20 mm and strands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
    [pickleball_paddle_elongated_mesh.stl, pickleball_paddle_elongated_mesh_core.stl]
